personalrobotics/tracking/hardware/finger_gelsight_assembly/gripper_assembly.SLDASM

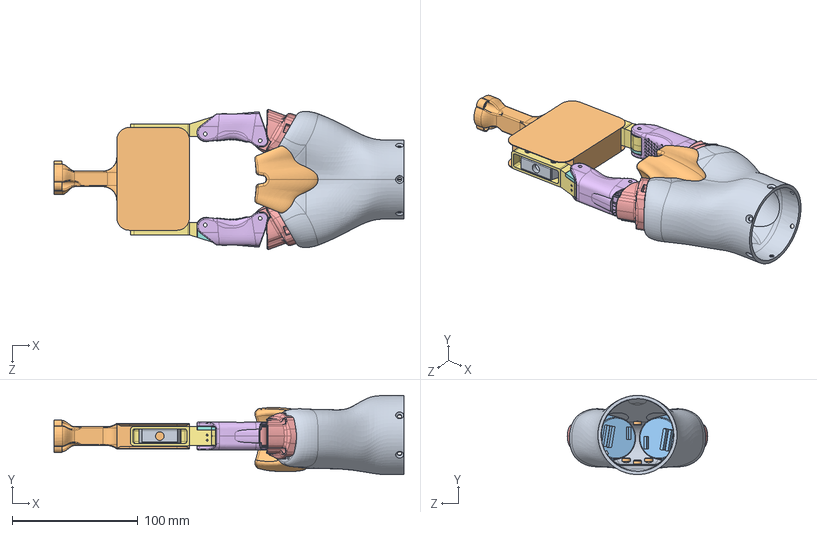
[picture p2: CAD file, 2020-10-12, last stored version]
hardware/finger_gelsight_assembly/gripper_assembly.SLDASM
278.9 x 63.0 x 112.0 mm
gripper_handshell
gripper_handfront
actuator_dummy x 2
actuator_cup x 2
gripper_fingershroud x 2
gripper_middlephalanx x 2
gelsight_shell x 2
gelsight_piece x 2
gelsight_corefilled x 2
forkholder
