personalrobotics/tracking/hardware/finger_gelsight_assembly/gripper_fingerassembly.sldasm

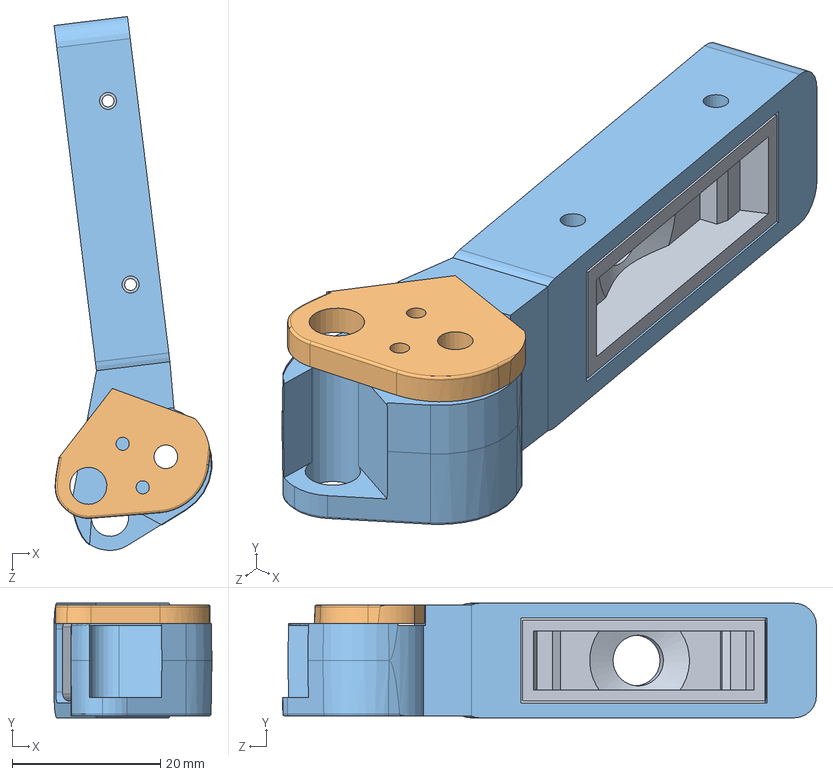
[picture p3: CAD file, 2020-10-12, last stored version]
hardware/finger_gelsight_assembly/gripper_fingerassembly.sldasm
21.3 x 15.5 x 72.2 mm
gelsight_shell
gelsight_piece
gelsight_corefilled
