personalrobotics/tracking/hardware/finger_gelsight_production/gelsight_corefilled_103.SLDPRT

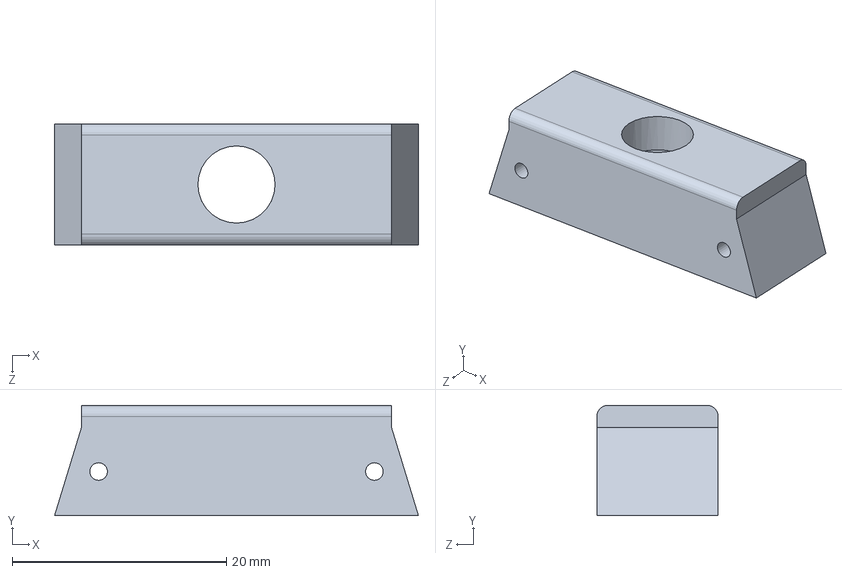
[picture p4: CAD file, 2020-10-12, last stored version]
hardware/finger_gelsight_production/gelsight_corefilled_103.SLDPRT
34.0 x 10.3 x 11.3 mm
