personalrobotics/tracking/hardware/finger_gelsight_production/forkholder.STL

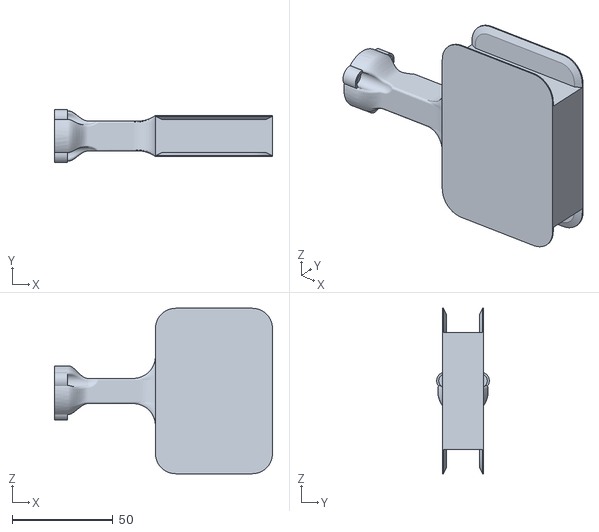
[picture p5: CAD file, 2020-10-12, last stored version]
hardware/finger_gelsight_production/forkholder.STL
108.0 x 26.1 x 82.0
