personalrobotics/tracking/hardware/finger_gelsight_assembly/gelsight_shell.sldprt

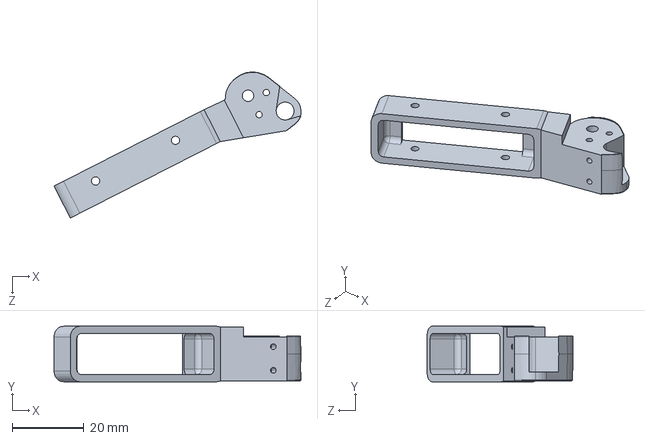
[picture p6: CAD file, 2020-10-12, last stored version]
hardware/finger_gelsight_assembly/gelsight_shell.sldprt
68.9 x 15.5 x 40.8 mm
