personalrobotics/tracking/hardware/finger_gelsight_production/gelsight_piece.STL

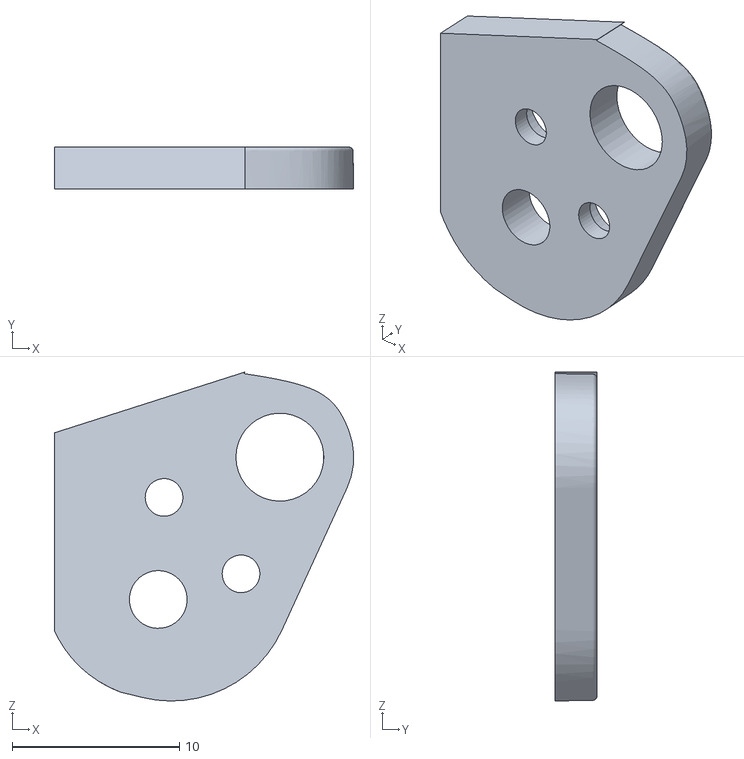
[picture p7: CAD file, 2020-10-12, last stored version]
hardware/finger_gelsight_production/gelsight_piece.STL
17.9 x 2.50 x 19.7
