personalrobotics/tracking/hardware/finger_gelsight_assembly/Body5.sldprt

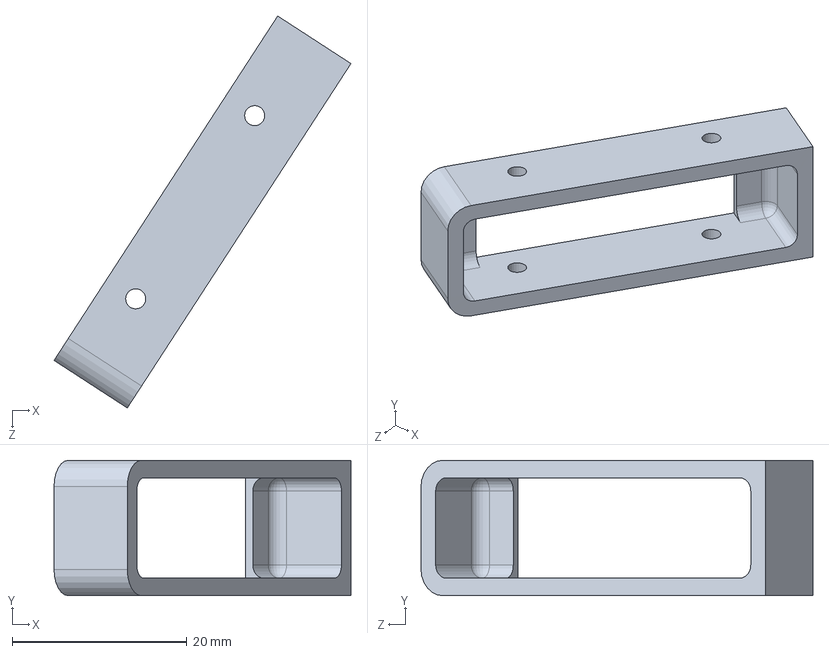
[picture p8: CAD file, 2020-10-12, last stored version]
hardware/finger_gelsight_assembly/Body5.sldprt
34.0 x 15.5 x 44.9 mm
