personalrobotics/tracking/hardware/finger_gelsight_assembly/gelsight_corefilled.SLDPRT

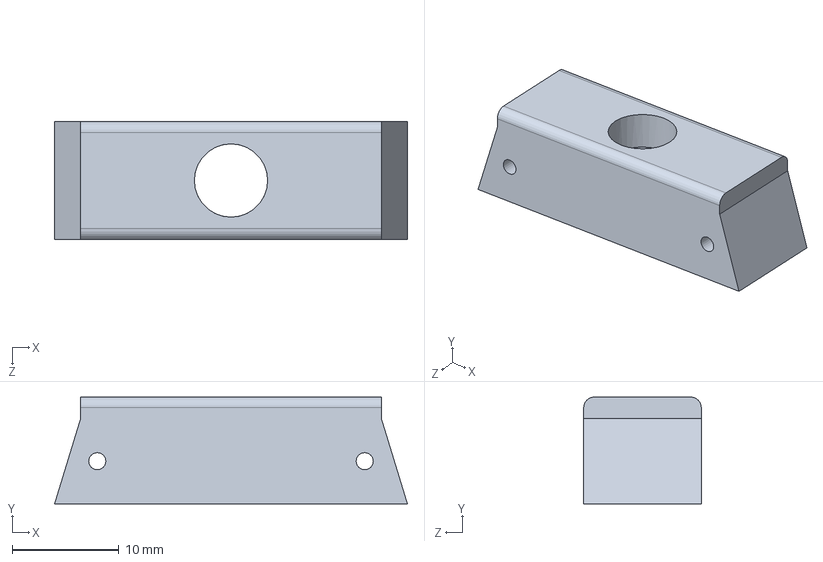
[picture p9: CAD file, 2020-10-12, last stored version]
hardware/finger_gelsight_assembly/gelsight_corefilled.SLDPRT
33.0 x 10.0 x 11.0 mm
