personalrobotics/tracking/hardware/finger_gelsight_assembly/gelsight_piece.sldprt

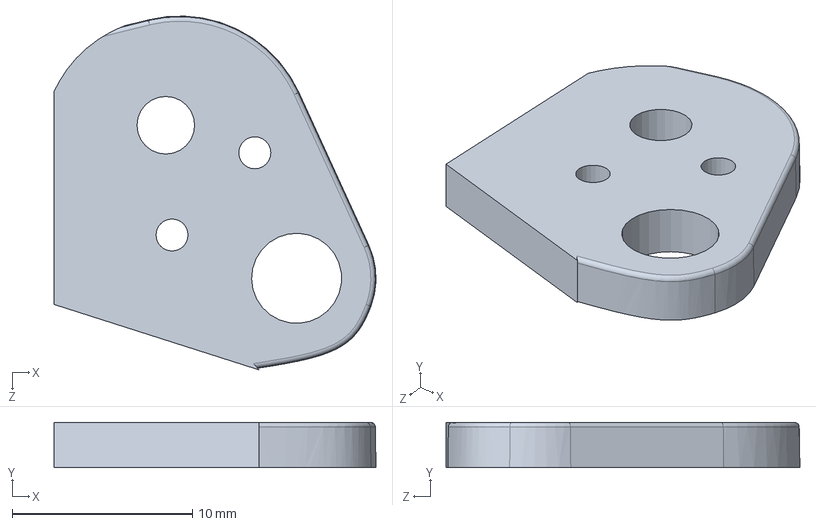
[picture p10: CAD file, 2020-10-12, last stored version]
hardware/finger_gelsight_assembly/gelsight_piece.sldprt
17.9 x 2.50 x 19.6 mm
