personalrobotics/tracking/(list of files, cad)

Other CAD files:
hardware/finger_gelsight_assembly/gripper_linearactuator.sldasm
hardware/finger_gelsight_assembly/MI 1502 0001 - 1.0.0.0002_simple_D‚faut.sldprt
hardware/finger_gelsight_assembly/gripper_handfront.sldprt
hardware/finger_gelsight_production/gelsight_shell.STL
hardware/finger_gelsight_assembly/MI 0000 0002 - 1.0.0.0005_simple_molded_version.sldprt
hardware/finger_gelsight_assembly/actuator_cup.sldprt
hardware/finger_gelsight_assembly/gripper_middlephalanx.sldprt
hardware/finger_gelsight_assembly/actuator_dummy.sldprt
hardware/finger_gelsight_assembly/gripper_fingershroud.sldprt
hardware/finger_gelsight_assembly/gripper_handshell.sldprt
hardware/finger_gelsight_assembly/forkholder.sldprt
hardware/finger_gelsight_production/gelsight_corefilled_103.STL
