personalrobotics/tracking/(commit log)

2020-02-20 gelsight_mini first update
    [pyvenv.cfg, susp-ignored.csv]
2020-03-07 Deleted figures and junk
    [pyvenv.cfg, susp-ignored.csv]
2020-10-12 Added Connor's hardware
    [Body5.sldprt, MI 0000 0002 - 1.0.0.0005_simple_molded_version.sldprt, MI 1502 0001 - 1.0.0.0002_simple_D‚faut.sldprt, actuator_cup.sldprt, actuator_dummy.sldprt, forkholder.STL, forkholder.sldprt, gelsight_corefilled.SLDPRT]
2020-11-03 Removing hardware files
    [Body5.sldprt, MI 0000 0002 - 1.0.0.0005_simple_molded_version.sldprt, MI 1502 0001 - 1.0.0.0002_simple_D‚faut.sldprt, actuator_cup.sldprt, actuator_dummy.sldprt, forkholder.STL, forkholder.sldprt, gelsight_corefilled.SLDPRT]
2020-11-06 updated prints
